cmosuea-arch/RV32-multicycle/docs/architecture/decisions.md

# Decisões arquiteturais

Data: 2026-09-11. Baseline inicial: `baseline-v1`.

1. Clock de subida, reset síncrono ativo alto. Guia nomeia clk_i/rst_i mas não
   define polaridade/tipo. Reset limpa RF, IR e registradores internos e reinicia
   PC em IMEM_BASE. DMEM não é apagada. Reset suprime escrita de memória.
2. PC retido durante a instrução; atualização somente em WRITEBACK. A frase do
   guia sobre incremento a cada clock não pode ser literal numa FSM multiciclo.
3. IMEM combinacional, DMEM síncrona conforme §4.3. Um estado MEMORY acomoda a
   latência; não há pipeline, stalls externos, CSRs, debug ou arquitetura Ibex.
4. Acessos desalinhados, endereços não mapeados, escrita na ROM e instruções não
   suportadas produzem FAULT persistente sem writeback/escrita. É diagnóstico
   interno CMOS, distinto do pedido de trap de ECALL/EBREAK no [EEI CMOS](system.md).
   Não há arquitetura privilegiada/CSRs; TRAP retém PC e motivo até reset.
   Branch não tomado não falha pelo alinhamento de um alvo não utilizado.
5. Sinais commit_* expõem aposentadoria para TB; não são interface oficial de
   pinos. Top de integração é provisório. UART/GPIO do desenho do guia carecem
   de contratos; não adicionar periféricos por suposição.
6. Blocos iniciais são integrados em bancadas progressivas até existir o core.
   Depois todas essas ligações são verificadas no processador. Não contabilizar
   instruções por teste isolado de ALU. Usar tags por marco para rastreabilidade.
7. Não usar uma instrução de sistema fictícia para terminar os testes. Firmware
   próprio escreve uma assinatura na DMEM e permanece em loop; TB detecta a
   assinatura. Testes por instrução observam commit_valid e timeout.
   ECALL/EBREAK usam trap_o/PC/motivo e não entram como aposentadorias no trace.
8. Não iniciar o fluxo físico do processador antes de ISA e firmware oficial
   validados, conforme AGENTS.md §33. A instalação e o smoke test do ambiente
   LibreLane são preparação de infraestrutura e não alteram esse marco. Lint
   não equivale a síntese física nem a GDSII.

## Pendências oficiais

Estado atual em 27/10: CRC e firmware publicados validados; sistema implementado
sob o EEI CMOS. P04 (interface final) segue aberta. Os parágrafos datados abaixo
preservam a sequência das decisões anteriores; não descrevem o perfil atual.

Decisão adicional em 2026-10-13: por autorização do usuário, desenvolver o
[CRC provisório CMOS](crc_provisional.md), habilitado por `EXPERIMENTAL_XICRC`.
O perfil padrão e a matriz oficial permanecem 41/47. P01 só se encerra após
confirmação do comportamento pela competição.

Ainda em 2026-10-13: `simple_system` usa ROM 2 KiB/RAM 1 KiB, bases preservadas,
CRC provisório ativo e assinatura em 0x100103f0. Linker separa pilha/dados.
ROM vira constantes e RAM vira registradores na síntese lógica genérica;
nenhuma macro física é presumida. Ver [contrato](../modules/simple_system.md).
O experimento não encerra requisitos do top final nem do firmware oficial.

| ID | Lacuna | Evidência | Impacto |
|---|---|---|---|
| P01 | Resolvida para a revisão publicada | Contrato implementado; unidade, core e firmware oficial PASS | Xicrc acrescentou três tipos; perfil atual tem 47/47 após sistema |
| P02 | Implementadas no EEI CMOS | [Contrato e limites](system.md); FENCE ordenada, ECALL/EBREAK com PC e motivo | 47/47 funcionais; eventual protocolo adicional da competição deve ser conferido |
| P03 | Resolvida para a revisão publicada | Imagem completa, x4 final e loop verificados; log/VCD arquivados | Firmware oficial PASS em RTL; sem declaração de signoff |
| P04 | pinos UART/GPIO e interface final de submissão | PDF pp.9–10: figura 12 pinos, tabela apenas clk/rst | top físico pendente |

A especificação RISC-V oficial complementa semântica e codificação das instruções
padronizadas; não resolve decisões exclusivas da competição.

Revisão de 20/10/2026: [esclarecimentos recebidos](clarifications_20261020.md).
Mantemos o RTL e os parâmetros atuais: o algoritmo CRC foi identificado, mas
faltam exemplos/pseudocódigo dos operandos. Não fixar `0xFFFF` em toda instrução
sem confirmar se a inicialização é por mensagem ou por operação. Os programas
próprios já são convertidos em palavras carregadas na IMEM; o oficial não chegou.

Revisão de 27/10/2026: [contrato extraído do firmware](crc_official_20261027.md).
A fonte agora está disponível; usa seed inicial por software e resultados
encadeados em rs2. A escolha CMOS anterior de rs1 como CRC e bytes baixos
primeiro deve ser substituída, com atualização de testes e evidências. Nesta
análise o RTL foi preservado; as decisões anteriores são histórico da implementação.

Adequação posterior em 27/10: CRC corrigido, perfil padrão habilitado e 44/47
verificadas. O nome EXPERIMENTAL_XICRC foi preservado para não quebrar configurações;
seu valor padrão agora é 1, e valor 0 mantém o subconjunto sem CRC. O firmware
oficial passa no RTL. A simulação usa a imagem publicada sem remontar assembly,
e só aceita x4 após a escrita final e três commits no loop. Síntese reservada ao usuário.

Fechamento funcional posterior em 27/10: [EEI CMOS](system.md) implementado.
FENCE preserva a ordenação serial; ECALL/EBREAK entram em TRAP=6, sem
aposentadoria, expondo trap_o/trap_ebreak_o/trap_pc_o até reset. FAULT=5 continua
sendo diagnóstico distinto. A interface foi ampliada no core/top de integração;
o simple_system preserva seus pinos e agrega trap em fault. 47/47 e 33 TBs/lint
PASS, firmware oficial novamente PASS (44 tipos). Sem síntese nesta revisão.
