cmosuea-arch/RV32-multicycle/labs/rtl-to-gds/01-visao-geral.md

# 1 — Visão geral do ambiente

[Anterior: arquitetura RISC-V](00-arquitetura-riscv.md) · [Índice](README.md) · [Próxima: testes unitários](02-testes-unitarios.md)

## Objetivo

Use a [aula 0](00-arquitetura-riscv.md) como base para reconhecer os blocos e
o caminho de uma instrução. Agora vamos ligá-los às ferramentas de verificação.

Identificar quem descreve o circuito, quem o estimula e quem decide se o resultado
está correto. RTL e testbench podem ser desenvolvidos juntos a partir do contrato
do bloco; a ordem de estudo aqui começa por um RTL que já existe.
Para abrir o projeto de cima para baixo, acompanhe o
[guia de leitura do código](../../docs/code_guide.md), começando pelos tops e
seguindo as conexões no core antes de estudar cada componente isolado.

## Arquivos envolvidos

| Arquivo ou diretório | Responsabilidade |
|---|---|
| [rtl/alu.sv](../../rtl/alu.sv) | função combinacional que será sintetizada |
| [tb/unit/tb_alu.sv](../../tb/unit/tb_alu.sv) | aplica entradas e compara saídas em simulação |
| [scripts/sim/vectors.py](../../scripts/sim/vectors.py) | calcula entradas e referências numéricas |
| [scripts/regression/run.py](../../scripts/regression/run.py) | chama ferramentas e verifica sucesso |
| [Makefile](../../Makefile) | associa nomes de comandos às receitas |
| [scripts/synth/simple.py](../../scripts/synth/simple.py) | transforma RTL em netlist e verifica sua execução |
| `build/` | vetores, ROMs e executáveis de simulação recriáveis |
| [results/logs/](../../results/logs/) | comandos executados e resultados |

## Explicação

```mermaid
flowchart TD
    M[make tb TB=tb_alu] --> P[run.py]
    P --> G[vectors.py]
    G --> V[alu.vec: entradas e referência]
    P --> I[iverilog: compilar e elaborar]
    R[alu.sv + tb_alu.sv] --> I
    I --> E[build/tb_alu]
    E --> S[vvp: simular]
    V --> S
    S --> C[Comparação no testbench]
    C --> L[PASS ou erro nos logs]
```

O simulador executa um modelo do circuito ao longo do tempo. Isso permite conferir
o comportamento antes da fabricação. A síntese, em outra etapa, transforma o RTL
em uma rede de células lógicas. Aprovação na simulação não garante área ou timing.

Python e Make executam no computador de desenvolvimento. O firmware é diferente:
ele é compilado para RISC-V e executado pelo core simulado. O testbench observa essa
execução e verifica, por exemplo, uma assinatura escrita em memória.

## Execução guiada

Inspecione a receita sem executar os testes:

```bash
make help
make -n tb TB=tb_alu
python3 scripts/regression/run.py --help
```

`make help` apresenta os alvos. A prévia de `tb` imprime uma chamada equivalente
a `python3 scripts/regression/run.py --test "tb_alu"`.
Se `.venv` existir, o interpretador será `.venv/bin/python`, selecionado pelo Makefile.
O `--help` do Python apresenta os modos disponíveis. Abra o Makefile e localize exatamente
a linha impressa. Não é o Make que calcula o resultado da ALU.

## Exercício e critério para avançar

Identifique os quatro papéis: quem calcula a referência, quem calcula a saída do
circuito, quem compara e quem inicia as ferramentas.

Resposta: `vectors.py`, `alu.sv`, `tb_alu.sv` e `run.py`, respectivamente. O Makefile
fornece a receita que inicia `run.py`. Avance quando conseguir explicar essa cadeia.

No percurso posterior, `make run` executa software no core, `make simple-synth`
gera/testa uma netlist e a aula 8 apresenta o ambiente físico. Cada comando
verifica uma etapa diferente do desenvolvimento.
