cmosuea-arch/RV32-multicycle/docs/modules/control_unit.md

# Control Unit
## Objetivo
Sequenciar execução multiciclo, Block Guide §3.2, PDF p.16.
## Entradas
clk_i/rst_i, illegal_i, load_i/store_i, fault_i e trap_i.
## Saídas
state_o[2:0], códigos em architecture/interfaces.md e RTL.
## Comportamento
FETCH → DECODE → EXECUTE → WRITEBACK. Loads/stores passam por MEMORY entre
EXECUTE e WRITEBACK. Erro entra em FAULT até reset.
ECALL/EBREAK vão de EXECUTE a TRAP=6 até reset, sem WRITEBACK. TRAP e FAULT
retêm estado mesmo se outras entradas mudarem; reset tem prioridade.
## Dependências
Decoder informa legalidade; core informa erros de endereço.
## Casos especiais
Reset vence erro; instrução não suportada não chega ao writeback.
## Diagrama
```mermaid
stateDiagram-v2
 [*] --> FETCH
 FETCH --> DECODE
 DECODE --> EXECUTE
 EXECUTE --> WRITEBACK
 EXECUTE --> MEMORY: load/store
 EXECUTE --> TRAP: ECALL / EBREAK
 MEMORY --> WRITEBACK
 WRITEBACK --> FETCH
 DECODE --> FAULT: ilegal
 FAULT --> FETCH: reset
 TRAP --> FETCH: reset
```
## Testbench
tb_control_unit e tb_core_smoke.
## Casos testados
Sequência básica, load/store de cinco ciclos, erro de decode, erro externo,
retenção de erro e reset. tb_memory_faults verifica cancelamento de store no reset.
Trap terminal, ausência de writeback, reset durante pedido e nova execução são
verificados em tb_control_unit e tb_core_system.
## Resultado
results/logs/tb_control_unit.log, tb_core_smoke.log e regressão PASS.
## Integração
Core instancia PC, IR, RF, Immediate e ALU. Primeira aposentadoria real.
## Commit validado
Tags core-smoke-v1 e isa-41-v1; evidências finais em rtl-subset-v0.1.
## Pendências
Diagramas ChipInventor. Fechamento funcional: tag isa-47-v1; evidência em
`results/experiments/isa-47-20261027/`.
