cmosuea-arch/RV32-multicycle/docs/openlane/environment.md

# Ambiente LibreLane/OpenLane

## Estado

O ambiente físico está instalado e validado no WSL2 por meio da imagem Docker
`isaiassh/unic-cass-tools:1.1.0` usada pelo repositório UNIC-CASS. A imagem fornece
LibreLane e ferramentas para o fluxo RTL até GDSII. A validação física registrada
usa um circuito de exemplo; nosso simple_system chegou à síntese lógica genérica.

Percurso didático: [aula 7 — síntese](../../labs/rtl-to-gds/07-sintese.md) e
[aula 8 — ambiente físico](../../labs/rtl-to-gds/08-introducao-openlane.md).
Comandos de síntese do sistema: [synthesis.md](../synthesis.md).
Configuração experimental para execução manual:
[openlane/simple_system](../../openlane/simple_system/README.md).

Versões verificadas em 2026-09-15:

Esta tabela descreve a imagem Docker. `make simple-synth` usa o Yosys disponível
no terminal do host, cuja versão fica em `results/logs/yosys_version.log`.

| Componente | Versão / identificação |
|---|---|
| LibreLane | `3.0.0rc1` |
| OpenROAD | `v2.0-25787-gee9759486` |
| Yosys da imagem | `0.44` |
| PDK | `sky130A` |
| PDK Volare | `0fe599b2afb6708d281543108caf8310912f54af` |

O verificador encontrou também Icarus Verilog, Verilator, Magic, Netgen,
KLayout, ngspice, xschem, OpenVAF, CACE e CVC-RV.

## Uso

Com Docker Desktop aberto e a integração desta distribuição WSL habilitada:
execute os alvos abaixo no **terminal WSL**, na raiz do clone. Eles iniciam o
contêiner automaticamente; não precisam de Docker instalado dentro da imagem.

```sh
make setup-openlane
make openlane-env-check
make openlane-env-smoke
make openlane-shell
```

`openlane-env-check` confirma ferramentas e PDKs. `openlane-env-smoke` executa
o projeto de teste embutido até GDSII em um diretório temporário. O shell abre
o contêiner com este repositório em
`/home/designer/shared/cmos-riscv` e com `PDK_ROOT=/opt/pdks`.

Dentro do contêiner, o wrapper padrão é:

```sh
bash scripts/openlane/librelane.sh <config.yaml>
```

A imagem é fixada pelo script para preservar a reprodução. Para testar outra
imagem sem editar o repositório, defina `UNICCASS_DOCKER_IMAGE`.

O wrapper monta somente o clone atual, mesmo se a pasta tiver outro nome.
Os scripts de verificação e chamada do LibreLane ficam em `scripts/openlane/`;
nenhum arquivo do repositório pai é necessário. Consulte [setup.md](../setup.md)
para preparar uma máquina nova. A tag da imagem é fixa; use um digest para
fixar também seu conteúdo de forma imutável.

## Validação realizada

O smoke test de infraestrutura percorreu 80/80 etapas em 59 segundos, gerou
GDSII e terminou com DRC, LVS e antena aprovados. Os avisos observados estão
registrados em `results/openlane/environment-smoke.md`.

Essa validação comprova o ambiente. O fluxo físico do `riscv_top` continua
aguardando ISA completa, firmware oficial, definição da interface física e uma
estratégia sintetizável para IMEM/DMEM, conforme `AGENTS.md`.

## Configuração preparada em 20/10/2026

`simple-openlane-synth`, `simple-openlane-floorplan` e `simple-openlane` foram
adicionados ao Makefile para exploração progressiva do sistema pequeno. As
receitas, escolhas e saídas estão no [roteiro do experimento](../../openlane/simple_system/README.md).
O usuário executará a síntese. Não há rodada SKY130A do sistema concluída nesta
preparação, nem área/timing/layout aprovados para registrar como resultado.
Os pré-requisitos de submissão final continuam separados do experimento com
firmware próprio e contrato CRC atual.
