cmosuea-arch/RV32-multicycle/docs/modules/branch_comp.md

# Branch Comparator
## Objetivo
Comparação de branches; Block Guide §3.1.6, PDF pp.15–16.
## Entradas
a_i/b_i[31:0], funct3_i[2:0].
## Saídas
taken_o.
## Comportamento
BEQ/BNE/BLT/BGE/BLTU/BGEU conforme funct3 oficial.
## Dependências
Nenhuma.
## Casos especiais
BLT/BGE signed; BLTU/BGEU unsigned. Códigos reservados retornam falso.
## Diagrama
```mermaid
flowchart LR
 A --> EQ[igualdade]
 B --> EQ
 A --> LT[menor signed / unsigned]
 B --> LT
 EQ --> MUX
 LT --> MUX
 F[funct3] --> MUX
 MUX --> TAKEN[taken]
```
## Testbench
tb_branch_comp, vetores Python independentes.
## Casos testados
Iguais, positivos, negativos, limites e aleatórios, todas as condições.
## Resultado
results/logs/tb_branch_comp.log e regressão PASS.
## Integração
tb_branch_pc: Comparator + Immediate + ALU + PC, tomado/não tomado e alvo negativo.
tb_isa executa seis branches no core, incluindo loops para trás e ambas as decisões.
## Commit validado
Tag block-branch-comp-v1.
## Pendências
ChipInventor para submissão.
