cmosuea-arch/RV32-multicycle/labs/rtl-to-gds/05-makefile.md

# 5 — Makefile: nomes curtos para receitas reproduzíveis

[Anterior](04-scripts-python.md) · [Índice](README.md) · [Próxima](06-regressao-e-evidencias.md)

## Objetivo e arquivo

Entender a construção do [Makefile real](../../Makefile) relacionando cada alvo
ao comando Python ou shell que você já conhece.

Comece com `make help`. O Makefile está organizado em preparação, testes,
execução do processador, sistema experimental e ambiente físico. As descrições
após `##` alimentam a ajuda: a receita usa `awk` para extrair nome e descrição
de cada alvo. `$$` passa um `$` ao shell, pois Make interpreta `$` primeiro.

## Da linha manual à receita

Na aula anterior usamos:

```bash
python3 scripts/regression/run.py --suite unit
```

Para dar um nome a essa ação, o Makefile contém:

```make
# O alvo unit executa a receita abaixo.
unit:
	$(PYTHON) scripts/regression/run.py --suite unit
```

`unit` é o alvo; a linha recuada é sua receita. O recuo da receita deve ser um
**TAB real**, não espaços. Se estiver escrevendo um Makefile e encontrar
`missing separator`, confira esse caractere.

Make também pode trabalhar com dependências, usando a forma
`alvo: dependencias`. No arquivo atual, os alvos são ações sem grafo de dependências
por arquivo. `simple-synth: simple-firmware` recompila o programa antes da síntese;
os três alvos `simple-openlane*` dependem de `simple-synth`, que também simula a
netlist antes do Docker. `.PHONY` evita que um arquivo chamado `unit` impeça a
receita. Cada chamada executa de novo; o Python controla a sequência interna.

`PYTHON` é uma variável: o Makefile escolhe `.venv/bin/python` quando instalado,
ou `python3` caso contrário. Também aceita `make unit PYTHON=/caminho/do/python`.
`make setup`, `make update` e `make doctor` preparam e conferem esse ambiente;
eles são explicados em [setup.md](../../docs/setup.md).

## Variáveis passadas no terminal

```make
# TB recebe, por exemplo, tb_alu pela linha de comando.
tb:
	$(if $(strip $(TB)),,$(error Informe a bancada: make tb TB=tb_alu))
	$(PYTHON) scripts/regression/run.py --test "$(TB)"
```

```bash
make -n tb TB=tb_alu
make tb TB=tb_alu
```

`$(TB)` é expandido por Make antes de enviar a receita ao shell. `-n` mostra a
receita sem executá-la nestes alvos. Informe um nome simples, como `tb_alu`;
sem `TB`, o Make informa o exemplo de uso antes de chamar Python. `strip` remove
espaços; `if` chama `error` quando o nome está vazio.

## Mapa das ações existentes

| Comando | Processo | Evidência agregada |
|---|---|---|
| `make help` | mostra descrições dos alvos | saída no terminal |
| `make clean` | arquiva build/logs/ondas para reiniciar a prática | backup local com inventário/hash |
| `make setup` | instala dependências e cria .venv | diagnóstico de ferramentas |
| `make update` | atualiza dependências declaradas | diagnóstico de ferramentas |
| `make doctor` | verifica ferramentas e compilador | saída no terminal |
| `make tb TB=tb_alu` | uma bancada | log da bancada |
| `make unit` | 14 TBs unitários | logs individuais |
| `make integration` | 19 TBs de integração, com sistema e firmwares | logs individuais |
| `make system` | FENCE e traps de ECALL/EBREAK | log e `system.json` |
| `make smoke` | quatro integrações rápidas | logs individuais |
| `make lint` | Verilator sem simulação | `lint.log` |
| `make test` | todos os TBs, sem lint | manifesto com lint `NOT_RUN` e cobertura |
| `make regression` | todos os TBs e lint | manifesto com lint `PASS` e cobertura |
| `make firmware` | GCC e conversão da imagem | log de build, ELF e hex |
| `make run` | compila e executa o firmware próprio no core | `tb_firmware.log` |
| `make wave` | firmware no RTL com VCD | log e waveform |
| `make official-fetch` | obtém/revalida a revisão fixada da imagem oficial | cache e inventário com READY |
| `make official-image` | converte a imagem em cache, offline | ROM, tags e metadados |
| `make official-run` | executa o firmware oficial no RTL | log e `official_firmware.json` |
| `make official-wave` | executa a imagem oficial com VCD | log e `official.vcd` |
| `make simple-firmware` | GCC gera programa experimental com CRC | `simple_build.log` e imagem ROM |
| `make simple-system` | firmware no sistema pequeno | `tb_simple_system.log` |
| `make simple-synth` | Yosys e simulação da netlist genérica | `simple_synth.json`, logs |
| `make simple-openlane-synth` | valida a netlist e mapeia para SKY130A | resumo da etapa synth, sem signoff |
| `make simple-openlane-floorplan` | valida a netlist e executa até floorplan | resumo da etapa floorplan |
| `make simple-openlane` | valida a netlist e inicia o fluxo físico completo | run isolado; resultados exigem revisão |
| `make openlane-env-check` | script shell → Docker → verificador | resultado no terminal |
| `make setup-openlane` | baixa imagem e verifica o ambiente físico | resultado no terminal |
| `make openlane-env-smoke` | script shell → Docker → exemplo físico | resultado no terminal |
| `make openlane-shell` | sessão interativa no contêiner | shell com ferramentas físicas |

Sem argumento, `make` executa `test`, definido por `.DEFAULT_GOAL`, mesmo com
`help` aparecendo primeiro no arquivo. Para fechamento use
explicitamente `make regression`, incluindo lint.

## Execução guiada

```bash
make -n unit
make -n integration
make -n regression
make -n openlane-env-smoke
```

Para cada linha impressa, encontre no Python ou shell o argumento correspondente.
No caso físico, o Make chama `environment.sh smoke`; esse shell é que inicia o
contêiner e chama LibreLane. O Make não faz síntese por conta própria.

Depois execute novamente uma receita pequena:

```bash
make tb TB=tb_rf_alu
```

O resultado deve ser o mesmo da execução direta feita na aula 3.
As etapas de síntese/OpenLane da tabela são roteiro de execução do usuário;
esta revisão dos comentários não as executa.

## Erros e execução sequencial

Uma ferramenta retorna um código de saída ao terminar. O executor Python transforma
falhas em saída diferente de zero; Make então interrompe a receita e informa erro.
Leia a mensagem anterior do Python e o log indicado para achar a causa original.

No alvo `help`, o prefixo `@` oculta o comando da receita para mostrar apenas a
ajuda. Ele não oculta falhas. `##` continua sendo comentário para Make; `awk`
lê essas descrições para montar a lista de comandos.

Use um comando por vez. `make -j` não é apropriado para estes alvos: eles escrevem
nos mesmos arquivos gerados e logs e não possuem isolamento para execução paralela.

## Exercício e critério para avançar

Qual a diferença entre `make firmware` e `make tb TB=tb_firmware`?
O primeiro só produz a imagem; o segundo também a executa no processador simulado
e verifica a assinatura. Avance quando conseguir seguir uma receita até a ferramenta
final e explicar por que Make e Python são camadas diferentes.

Para estudar uma dependência real, use `make -n simple-synth`: o build do firmware
aparece antes da chamada de síntese. A [aula 7](07-sintese.md) executa esse percurso.
