cmosuea-arch/RV32-multicycle/results/experiments/firmware-wave/firmware-boot.png

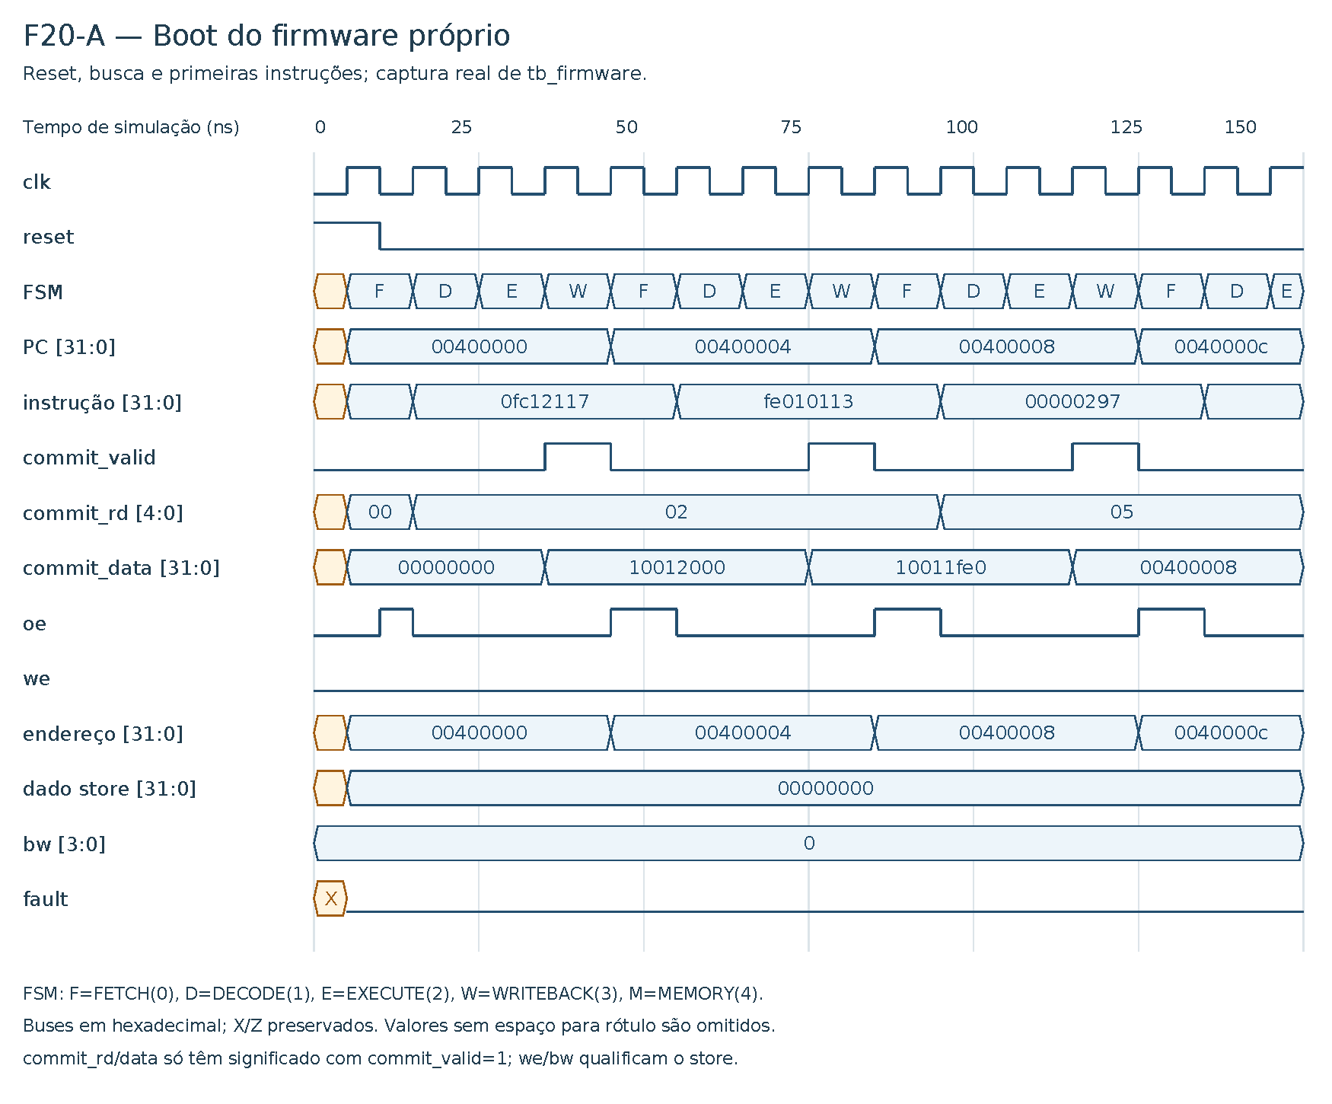
results/experiments/firmware-wave/firmware-boot.png
