cmosuea-arch/RV32-multicycle/results/experiments/firmware-wave/firmware-signature.png

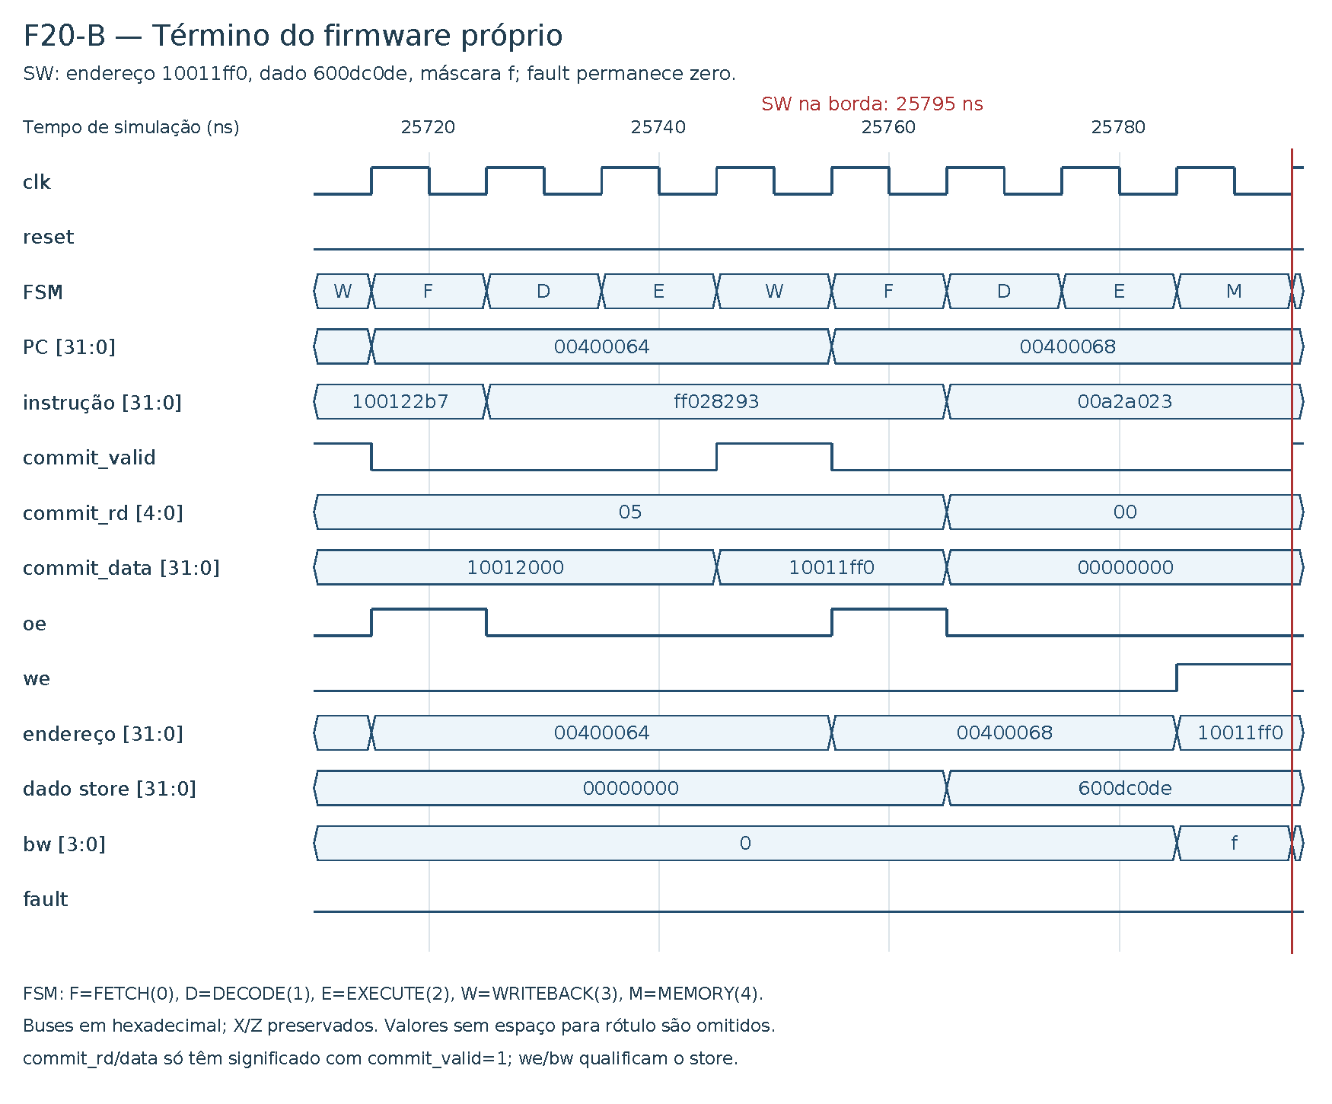
results/experiments/firmware-wave/firmware-signature.png
