cmosuea-arch/RV32-multicycle/rtl/imm_ext.sv

`timescale 1ns/1ps
// Reconstrói o imediato de 32 bits a partir dos campos espalhados na instrução.
module imm_ext(input logic [31:0] instr_i, output logic [31:0] imm_o);
    function automatic [31:0] extend(input [31:0] ins);
        begin
        // O opcode identifica I/S/B/U/J. Repetir ins[31] faz extensão de sinal.
        // B e J incluem o bit zero implícito; U reserva os 12 bits inferiores.
        case (ins[6:0])
            7'h03,7'h13,7'h67: extend={{20{ins[31]}},ins[31:20]};
            7'h23: extend={{20{ins[31]}},ins[31:25],ins[11:7]};
            7'h63: extend={{19{ins[31]}},ins[31],ins[7],ins[30:25],ins[11:8],1'b0};
            7'h17,7'h37: extend={ins[31:12],12'b0};
            7'h6f: extend={{11{ins[31]}},ins[31],ins[19:12],ins[20],ins[30:21],1'b0};
            // FENCE e SYSTEM não usam esta saída; o decoder os trata separadamente.
            default: extend=0;
        endcase
        end
    endfunction
    assign imm_o = extend(instr_i);
endmodule
