cmosuea-arch/RV32-multicycle/tb/integration/tb_core_crc.sv

`timescale 1ns/1ps
module tb_core_crc;
    // Verifica Xicrc no core: decode, execução, writeback, dependências e memória.
    reg clk=0; always #5 clk=~clk;
    wire trap,trap_ebreak;
    wire [31:0] trap_pc;
    reg rst=1;
    wire fault,valid;
    wire [31:0] cpc,ci,cd;
    wire [4:0] rd;
    reg [31:0] epc,ei,ed;
    reg [4:0] erd;
    integer fd,status,n,cycles,crc_count,i;
    riscv_top #(.IMEM_WORDS(65536),.IMEM_FILE("build/crc.hex"),.EXPERIMENTAL_XICRC(1))
        dut(clk,rst,fault,valid,cpc,ci,cd,rd,trap,trap_ebreak,trap_pc);
    initial begin
        // ROM e trace CRC foram gerados separadamente da cobertura oficial da baseline.
        fd=$fopen("build/crc.trace","r");
        if(!fd) $fatal(1,"missing CRC trace");
        @(posedge clk); #1; @(negedge clk); rst=0;
        n=0; cycles=0; crc_count=0;
        while(!$feof(fd)) begin
            // Lê a próxima aposentadoria prevista: PC, instrução, destino e resultado.
            status=$fscanf(fd,"%h %h %h %h\n",epc,ei,erd,ed);
            if(status!=4) $fatal(1,"bad CRC trace");
            begin : await_commit
                // Aguarda valid, com timeout; disable encerra esta espera após uma comparação válida.
                forever begin
                    @(posedge clk); cycles=cycles+1;
                    if(fault || cycles>200000) $fatal(1,"CRC fault/timeout pc=%h",cpc);
                    if(valid) begin
                        if({cpc,ci,rd,cd}!=={epc,ei,erd,ed})
                            $fatal(1,"CRC trace #%0d pc=%h data=%h expected=%h",n,cpc,cd,ed);
                        if(ci[6:0]==7'h33 && ci[31:25]==7'h40) crc_count=crc_count+1;
                        #1;
                        // Confere a escrita real; x0 é constante e não tem célula regs[0] no RF.
                        if(erd!=0 && dut.core.register_file.regs[erd]!==ed) $fatal(1,"CRC RF mismatch");
                        disable await_commit;
                    end
                    #1;
                end
            end
            n=n+1;
        end
        if(crc_count!=2146) $fatal(1,"incomplete CRC trace: %0d",crc_count);
        // Cada mensagem é gravada três vezes, agrupada por byte/halfword/word.
        for(i=0;i<6;i=i+1)
            if(dut.data_memory.mem[i]!==((i<3)?32'h29b1:32'h1e82))
                $fatal(1,"CRC stream packing/store failed slot=%0d",i);
        // Reset após uso da extensão limpa estado arquitetural e reinicia o fetch.
        @(negedge clk); rst=1; @(posedge clk); #1;
        if(valid || fault || dut.core.register_file.regs[1]!==0 || dut.core.current_pc!==32'h00400000)
            $fatal(1,"CRC reset failed");
        $display("PASS core_crc: %0d retirements, %0d CRC, overlap/x0/stream/store/reset",n,crc_count);
        $finish;
    end
endmodule
