cmosuea-arch/RV32-multicycle/tb/unit/tb_lsu.sv

`timescale 1ns/1ps
module tb_lsu;
    // Verifica formatação de loads/stores, máscaras de bytes e acessos inválidos.
    reg [31:0] addr,src,mem,eld,esd;
    reg [2:0] f;
    reg st,ebad,einvalid;
    reg [3:0] ebw;
    wire [31:0] ld,sd;
    wire [3:0] bw;
    wire bad,invalid;
    integer fd,status,n;
    lsu dut(addr,src,mem,f,st,ld,sd,bw,bad,invalid);
    initial begin
        // Referência Python: dados de load/store, byte enables e flags de erro esperados.
        fd=$fopen("build/lsu.vec","r"); n=0;
        if(!fd) $fatal(1,"missing LSU vectors");
        while(!$feof(fd)) begin
            // Dez campos por caso; um arquivo incompleto encerra o teste com $fatal.
            status=$fscanf(fd,"%h %h %h %h %h %h %h %h %h %h\n",addr,src,mem,f,st,eld,esd,ebw,ebad,einvalid);
            if(status!=10) $fatal(1,"bad vector");
            #1;
            // Compara todas as saídas juntas; !== reprova também resultados indefinidos.
            if({ld,sd,bw,bad,invalid}!=={eld,esd,ebw,ebad,einvalid}) $fatal(1,"LSU addr=%h f=%h store=%h",addr,f,st);
            n=n+1;
        end
        if(n<8000) $fatal(1,"insufficient vectors");
        // A contagem impede PASS por leitura acidental de poucos vetores.
        $display("PASS lsu: %0d byte/half/word, signed/unsigned, masks and invalid vectors",n); $finish;
    end
endmodule
