cmosuea-arch/RV32-multicycle/(commit log)

2026-09-11 feat(ir): validate capture hold reset and immediate integration
    [ir.sv, tb_ir.sv, tb_ir_imm.sv]
2026-09-11 fix(sim): use continuous function evaluation and reject compile diagnostics
    [alu.sv, imm_ext.sv]
2026-09-11 feat(isa): validate 10 register operations and traceable 11 of 47 coverage
    [coverage.csv]
2026-09-11 feat(isa): validate nine immediate operations and 19 of 47 coverage
    [coverage.csv]
2026-09-11 feat(isa): implement LUI AUIPC and validate 21 of 47 instructions
    [coverage.csv]
2026-09-11 feat(branch): integrate six conditions and validate 27 of 47 instructions
    [coverage.csv]
2026-09-11 feat(jump): validate JAL JALR and fault handling at 29 of 47 instructions
    [coverage.csv]
2026-09-11 feat(load-store): validate 37 instructions with synchronous memory and fault isolation
    [coverage.csv]
2026-09-11 feat(zmmul): integrate multiplication and validate 41 of 47 instructions
    [coverage.csv]
2026-09-12 feat(firmware): validate C demo and finalize documented 41-instruction subset
    Own RV32I_Zmmul firmware reaches signature 600dc0de. Preserve 28 passing testbenches, clean Icarus compilation and Verilator lint. Record source hashes, per-instruction evidence, smoke/wave commands and explicit official blockers. OpenLane and final competition release remain pending.
    [coverage.csv]
2026-09-15 docs(coverage): add formatted Excel workbook
    Generate coverage.xlsx from the canonical CSV with summary and instruction sheets, filters, frozen headers, status colors, and adjusted columns. Preserve the Markdown view and expose both formats from the README.
    [coverage.xlsx]
2026-09-27 test(regression): add staged RTL test workflow
2026-10-03 docs(lab): add guided RTL verification and physical flow lessons
2026-10-10 chore(setup): automate Ubuntu dependencies and portable LibreLane environment
    Add install/update scripts, requirements and toolchain diagnostics for fresh clones. Select the local Python environment from Make and remove parent-workspace dependencies from the physical-flow wrapper.
    Validated installation and reinstallation in clean Ubuntu 24.04: 28 testbenches, firmware and Verilator lint PASS. LibreLane smoke PASS with host and alternate UID/GID. Preserve pre-existing user log changes.
2026-10-14 feat(system): add small CRC demo system with synthesized-netlist validation
    Add a 2 KiB ROM / 1 KiB RAM experimental system, startup/linker/C firmware, signature outputs and reset/failure tests. Fix competing IMEM initialization so synthesis preserves the program. Add Yosys synthesis and pin-level netlist simulation targets, dependency checks and updated lab documentation.
    Validation: 31 RTL testbenches PASS; Verilator lint for baseline and experimental tops PASS; generic synthesis maps memories with no register initialization and the netlist completes two firmware boots. Official coverage remains 41/47; provisional CRC is tracked separately. Existing user logs are preserved.
    [imem.sv, main.c, simple.py, simple_system.sv, tb_simple_netlist.sv]
2026-10-14 docs(tb): explain testbench setup, tasks and self-checks
    Add brief Portuguese comments to all 14 unit benches, 17 integration benches and the synthesized-netlist bench. Explain stimulus timing, references, helper tasks, commit checks, reset/fault scenarios and success criteria.
    Validation: insertion-only comparison confirms executable code is unchanged. All 31 RTL benches compile with Icarus -Wall; the netlist bench compiles against the validated generic netlist with the synthesis-flow options. Existing user logs are preserved.
    [tb_address_decoder.sv, tb_alu.sv, tb_branch_comp.sv, tb_branch_pc.sv, tb_control_unit.sv, tb_core_crc.sv, tb_core_faults.sv, tb_core_smoke.sv]
2026-10-15 docs(lab): add synthesis lesson and refresh development workflow
    Add lesson 7 for automatic and manual Yosys synthesis, generated artifacts, netlist simulation, memory behavior and result interpretation. Move physical environment preparation to lesson 8 and update README, lab navigation, scripts, execution commands, module contracts and verification guidance.
    Validation: seven synthesis lesson command blocks passed in an isolated copy before interruption, including RTL simulation, automatic/manual synthesis and both netlist simulations. Final checks validated links and code fences in 42 documents, previews of 58 Make commands, eight-lesson navigation and 14+17 bench counts. Preserve existin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
2026-10-15 docs(report): draft phase 2 report from submission guide
    Document the six required topics, development method and recorded RTL evidence. Add a 15-page preliminary PDF, requirement checklist and optional exporter. Validate ISA tables against CSV, local links, PDF layout and page-limit handling; preserve existing logs and do not rerun RTL or physical flows.
2026-10-17 docs(report): add reviewed datapath and control figures
    Draw execution, PC/memory and control from the current RTL; include SVG/PNG panels in the 17-page preliminary report. Add local image export and track official dependencies and completion order. Checked figure presentation, links, ISA table consistency, PDF images/page count and failure preservation. No RTL changed or regression rerun.
2026-10-17 docs(firmware): capture verified smoke waveforms for report
    Run make wave in an isolated snapshot and archive its VCD, build/test logs and hashes. Validate the synchronous signature store and counters, export actual boot/completion traces and include them in the 19-page report. Checked compressed/raw parsing, pre-edge sampling and rejection of corrupted signatures, masks, faults and counts. Only tb_firmware was rerun; no RTL or full-regression changes.
2026-10-17 docs(report): condense report and reserve space for diagrams
    Reduce the preliminary PDF from 19 to 12 pages while preserving required sections, ISA tables, 17 module descriptions, datapath and completion waveform. Consolidate repetitive text and tests into tables, reserve eight pages for pending diagrams and final results, and record diagram ownership. Checked local links, ISA/module coverage, PDF layout/page count and exporter limits; no RTL simulation or physical flow executed.
2026-10-17 chore(lab): reset generated outputs for guided video practice
    Archive build/logs/waves with integrity inventories, preserve 65 existing working logs as a labeled historical snapshot and ignore future runtime outputs. Add make clean and a guided study/video route in the current workspace. Retarget recorded ISA evidence links without changing results. Checked cleanup on fixtures, hashes, CSV/XLSX, links and Make previews; no RTL tests or physical flow run. Preserve user Makefile spacing outside this commit.
    [coverage.csv, coverage.xlsx]
2026-10-17 estrutura parcial validada
    [coverage.csv, coverage.xlsx]
2026-10-27 fix(crc): match official Xicrc contract and validate stage 2 firmware
    Use rs1 for data and rs2 for the previous CRC16; process selected bytes
    most significant first. Preserve encodings and the multicycle FSM, enable
    Xicrc by default, and keep the historical parameter as an opt-out.
    Add SHA-pinned official image preparation and a terminal-write/loop test,
    including dynamic coverage of 44 instruction types. Update reference
    models, own firmware, coverage, labs, module diagrams and the v0.6 report.
    Archive reproducible regression logs, official VCD and a checked waveform.
    Validation: 32 RTL testbenches and lint for both tops PASS; 18,304 CRC
    vectors; 88,727 ISA retirements. Official firmware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
    [coverage.csv, coverage.xlsx]
2026-10-27 feat(system): complete 47-instruction profile with precise EEI traps
    Implement ordered FENCE and exact ECALL/EBREAK decoding with a terminal TRAP state, separate from illegal-instruction FAULT. Expose trap type and PC through core/top and preserve the reduced simple_system interface.
    Validate 33 RTL testbenches and both lint tops, 512 FENCE executions, 256 traps per instruction, reset recovery, and the unchanged official firmware (44 types). Reject stale or inflated coverage, archive manifests/logs/VCD, and update the 12-page report and labs. No synthesis or physical signoff performed.
    [coverage.csv, coverage.xlsx]
2026-10-27 docs: align project guides and code comments with 47-instruction profile
    Explain RTL/TB/Python/Make/firmware connections, ordered FENCE and precise terminal traps. Correct stale CRC operand examples, integration counts, firmware receipt and synthesis status; preserve historical evidence and the isa-47-v1 tag.
    Verified unchanged Python ASTs and RTL/TB/firmware tokens across 35 code files, 12 unchanged Make dry runs, shell syntax, and a fresh isolated 33-testbench regression with both lint tops and official firmware PASS. Archive review manifests without overwriting practice builds/logs. No synthesis performed.
    [address_decoder.sv, control_unit.sv, crc.sv, decoder.sv]
